profesionalentieu/lockers-unraf/HARDWARE.md

# Armado del sistema real — procedimiento de puesta a punto

Guía para pasar del simulador al gabinete funcionando. El orden importa: cada etapa se prueba
sola antes de sumar la siguiente, así cuando algo falla sabés exactamente qué lo rompió.

**La regla que más tiempo ahorra: nunca sumes dos cosas nuevas a la vez.** Si conectás el
registro de desplazamiento y los solenoides en el mismo paso y no anda, tenés dos sospechosos y
ninguna forma barata de distinguirlos.

---

## 0. Antes del viernes (hacelo ahora, son descargas)

Si esto queda para el día que llegan las placas, se les va la mañana bajando paquetes.

El firmware es **ESP-IDF 6.1** y se trabaja desde **VS Code** (ya no se usa el IDE de Arduino).
El detalle está en [`firmware/README.md`](firmware/README.md); en corto:

1. **VS Code** y la extensión **ESP-IDF** de Espressif.
2. `F1` → **ESP-IDF: Open ESP-IDF Installation Manager** → instalar **ESP-IDF v6.1** con los
   targets **esp32s3** y **esp32c3**. Son ~2 GB: no lo dejes para el día del armado.
3. Abrir `firmware/lockers.code-workspace` y compilar una vez cualquier proyecto (por ejemplo
   `pruebas/obtener_mac`): la primera compilación baja cJSON del registro de Espressif y deja
   todo listo. Las librerías ya no se instalan a mano: cada proyecto declara las suyas.

### Checklist de componentes

Además de las placas, para el prototipo hacen falta:

| Qué | Cuánto | Para qué |
|---|---|---|
| Resistencias 10 kΩ | 8 | Pull-down en los gates de los MOSFET |
| Resistencias 220–330 Ω | 4 | Para los LEDs de prueba (etapa 3) |
| SN74HC595 | 1 | Expande 3 pines del micro a 8 salidas |
| LEDs comunes | 4 | Probar el registro sin riesgo antes de conectar potencia |
| Diodos 1N4007 | 4 (uno por solenoide) | **Flyback**: sin esto se queman los MOSFET |
| Capacitor electrolítico 470–1000 µF / 25 V | 1 | Absorbe el pico de corriente del pulso |
| Capacitor cerámico 100 nF | 1 por integrado | Desacople de alimentación |
| Fuente 12 V, 2 A mínimo | 1 | El pulso de servicio dura 15 s y el firmware permite 2 bobinas a la vez: con solenoides de 600 mA son 1,2 A sostenidos; 2 A da margen para el pico de arranque |
| Multímetro | 1 | Medir consumo real y verificar continuidad |
| Protoboard y jumpers | — | Todo el armado previo al gabinete |

---

## 1. Las placas solas (30 min)

Antes de cablear nada: conectá cada placa por USB y grabá **`firmware/pruebas/obtener_mac`**
(*Build, Flash and Monitor*). Confirma cuatro cosas de una: que el cable es de datos y no solo de
carga, que el puerto aparece, que la placa entra en modo programación, y la MAC para etiquetarla.

> Si la PC no detecta la placa: mantené apretado el botón **BOOT**, conectá el USB, soltá. Eso
> fuerza el modo bootloader. En Windows revisá el Administrador de dispositivos para ver en qué
> COM aparece.

---

## 2. El enlace ESP-NOW, con nada más conectado (1 h, es la etapa crítica)

**No sigas a la etapa 3 hasta que dos placas peladas se hablen.** Sumarle registros y solenoides
a un enlace que no funciona solo agrega variables.

ESP-NOW usa el WiFi que el ESP32-S3 trae adentro, así que **no hace falta ningún módulo de radio
externo**: alcanza con las dos XIAO y sus antenas de 2,4 GHz. Verificá que la antena chica esté
conectada al conector IPEX antes de energizar.

En `firmware/pruebas/` hay dos proyectos para esta etapa (en las pruebas hay que elegir el
target: *ESP-IDF: Set Espressif Device Target* → `esp32s3`):

- **`obtener_mac`** — imprime la MAC de cada placa. El firmware usa difusión y no la necesita,
  pero anotarlas sirve para etiquetar las placas y para diagnosticar.
- **`prueba_espnow`** — ping-pong entre las dos, con RTT, RSSI de los dos extremos y porcentaje
  de entrega. Cambiás `#define ES_SONDA` (1 o 0) en `main/main.c` antes de grabar cada una.

### El canal es la falla número uno

Las dos placas tienen que estar en el **mismo canal WiFi** (`#define CANAL 1`). Si difieren, las
dos arrancan sin dar ningún error y simplemente no se ven. Antes de sospechar del código, revisá
el canal.

### La medición que importa

En la mesa el enlace va a funcionar sí o sí. Lo que hay que medir es el **alcance real en el
edificio**, porque a 2,4 GHz el hormigón atenúa mucho: una placa fija donde va a estar el gateway,
la otra caminando, anotando RSSI y porcentaje de entrega a cada distancia. Contra los cientos de
metros de LoRa, esperá entre 20 y 50 metros en un pasillo.

Esa tabla decide dónde puede estar el gateway, y queda muy bien en el informe.

---

## 3. El registro de desplazamiento, con LEDs (1 h)

Ahora sí, el SN74HC595 — pero manejando LEDs, no solenoides. Es la prueba más barata de que toda
la cadena software → radio → firmware → registro funciona.

### Conexionado

| Pin del 595 | Va a |
|---|---|
| 14 (SER / DS) | D1 = GPIO2 de la XIAO (`PIN_SR_DATOS`) |
| 11 (SRCLK) | D2 = GPIO3 (`PIN_SR_RELOJ`) |
| 12 (RCLK / LATCH) | D3 = GPIO4 (`PIN_SR_LATCH`) |
| 10 (SRCLR) | VCC (activo en bajo: si queda suelto, borra el registro) |
| 13 (OE) | GND (ver la nota de abajo) |
| 16 (VCC) y 8 (GND) | Alimentación, con un 100 nF entre ellos |
| Q0–Q3 | LED + resistencia de 330 Ω a GND |

### ⚠ Alimentación del 595: 3,3 V, no 5 V

El ESP32 trabaja a 3,3 V. Si alimentás el 595 a 5 V, su umbral de entrada alta es 0,7 × VCC =
**3,5 V**, o sea que los 3,3 V del ESP32 no alcanzan a garantizar un "1" lógico: puede andar en
el banco de pruebas y fallar de forma intermitente después. Dos salidas correctas:

- **Alimentar el 595 a 3,3 V** (lo más simple). El umbral baja a 2,31 V y el ESP32 lo maneja sin
  problema. La contra: el gate del MOSFET recibe solo 3,3 V.
- **Usar un SN74HCT595 alimentado a 5 V.** La variante **HCT** tiene entradas con niveles TTL
  (umbral 2 V), así que acepta los 3,3 V del ESP32 y entrega 5 V al gate, que es mejor para el
  MOSFET. Si todavía están a tiempo de pedir, esta es la opción más prolija.

El IRLZ44N es de nivel lógico y conmuta con 3,3 V para corrientes de este orden, pero queda menos
holgado. Si van por 3,3 V, **medí la caída entre drain y source con el solenoide activo**: si es
de décimas de volt, está bien; si el MOSFET se calienta, no está saturando y conviene pasar a
HCT a 5 V.

### El arranque

Al energizar, las salidas del 595 quedan en estado indefinido hasta el primer latch. Con OE a
masa eso se traduce en que **un solenoide puede dispararse solo al prender el equipo**. Por eso
los pull-down de 10 kΩ en cada gate. Si quieren la solución más prolija: OE con un pull-up de
10 kΩ a VCC (salidas en alta impedancia al arrancar) y un GPIO que lo lleve a masa recién después
de que el firmware puso el registro en cero.

**Prueba:** grabá `firmware/nodo`, levantá el backend y el gateway, y validá un código en la
pantalla del locker. El LED tiene que prenderse **15 segundos** (el pulso de servicio). Si eso
pasa, el software está completo y lo que falta es solo potencia.

---

## 4. Los finales de carrera (30 min)

Un extremo del microswitch a **GND**, el otro al GPIO. En el firmware tienen el pull-up interno
habilitado (`componentes/puertas`), así que en reposo leen alto y al apretarse leen bajo. No hacen
falta resistencias externas, **salvo en D6 y D7 de la XIAO** (GPIO43/44): son el TX/RX de la
UART0 y la ROM escribe en GPIO43 al arrancar; con la puerta cerrada eso es un cortocircuito breve.
Poné 1 kΩ en serie en esos dos cables (detalle en `firmware/README.md`).

Los microswitch tienen tres patas: **COM**, **NO** (normalmente abierto) y **NC** (normalmente
cerrado). **No confíes en la posición**: en algunos modelos el terminal del medio no es COM. Mirá
lo impreso en el cuerpo del switch, o probalo.

**Se usan COM y NO**, con el switch montado de modo que la puerta cerrada apriete la palanca:

| Situación | Palanca | Contacto C-NO | Lectura | Estado |
|---|---|---|---|---|
| Puerta cerrada | apretada | cerrado | LOW | cerrada |
| Puerta abierta | libre | abierto | HIGH | abierta |

Usar NC invierte todo. Y hay una razón de seguridad para preferir NO: si se corta un cable o el
switch se afloja, el circuito queda abierto y el sistema reporta **puerta abierta**, que es el
estado seguro — salta la alerta en lugar de mostrar cerrada una puerta que no lo está.

Abrí el monitor (*ESP-IDF: Monitor Device*) y verificá que aparezca `Puerta N -> ABIERTA` /
`cerrada` al soltar y apretar cada uno. El antirrebote ya está en el firmware, pero un contacto
sucio puede generar lecturas erráticas: si ves rebotes, subí `ms_antirrebote` en
`componentes/puertas/include/puertas.h` (`PUERTAS_CONFIG_DEFECTO`).

---

## 5. La potencia (1–2 h, la etapa donde se queman cosas)

> **Se puede hacer sin el registro de desplazamiento y sin radio.** Un MOSFET colgado de un GPIO
> alcanza para validar toda la cadena de una puerta. Usá
> `firmware/pruebas/prueba_actuador` (en la XIAO usa D1 como gate y D4 como switch; en la C3
> SuperMini, GPIO0 y GPIO5), que busca por barrido la duración mínima
> que necesita la cerradura y, con el comando `v`, hace el **pulso de servicio de 15 s** que pide la
> especificación (la ventana para tirar de la puerta). Hacé `v` cinco veces seguidas y tocá la
> bobina: es el peor caso real de calentamiento.

Recién ahora los 12 V. Tres cosas que arruinan prototipos, en orden de frecuencia:

**Diodo flyback.** Un solenoide es una bobina: al cortar la corriente genera un pico de tensión
inverso que puede superar los 100 V y se lleva puesto el MOSFET. El 1N4007 va en paralelo con la
bobina, **cátodo (la franja) al positivo de 12 V**. Sin este diodo el MOSFET dura horas, no meses.

**Masa común.** El negativo de la fuente de 12 V y el GND del ESP32 tienen que estar unidos. Sin
esa referencia, el gate del MOSFET no tiene contra qué medir su tensión y el circuito hace cosas
impredecibles. Es el error más común y el más difícil de diagnosticar, porque a veces "casi"
funciona.

**No alimentes el XIAO desde los 12 V** sin un regulador. Para el prototipo, dejá el XIAO por USB
y la fuente de 12 V solo para los solenoides, con las masas unidas.

### El armado por MOSFET

```
   12 V ──┬──────────────┐
          │           [solenoide]
        [1N4007]         │
   (cátodo arriba)       │
          └──────────────┤
                         │
                       DRAIN
   Q0 del 595 ──[gate]  IRLZ44N
                  │    SOURCE
               [10 kΩ]    │
                  │       │
   GND ───────────┴───────┴──── (misma masa que el ESP32)
```

### Medición antes de confiar

Con la fuente de banco (si tienen) o el multímetro en serie, **medí cuánto consume un solenoide
durante el pulso**. Los de 12 V suelen pedir entre 0,5 y 1 A, con un pico mayor al inicio. Ese
número define la fuente. Poné el capacitor de 470–1000 µF cerca de los solenoides: absorbe el
pico y evita que la tensión se hunda y reinicie el ESP32.

Con el pulso de 15 s ya no alcanza con "de a uno por vez" (dos personas en dos puertas distintas
esperarían 15 s una a la otra). El firmware permite **como máximo 2 bobinas energizadas a la vez**
(`MAX_SIMULTANEOS`) y **separa los arranques 300 ms** (`MS_ENTRE_ARRANQUES`) para que los picos no se
sumen. Si la fuente es más chica, bajen `MAX_SIMULTANEOS` a 1: la segunda orden espera su turno.

**Y la salida vuelve a cero siempre.** Si un solenoide queda energizado de más se calienta, consume
y termina quemándose. El firmware apaga cada salida al vencer su pulso (`atenderPulsos()`) y nunca
acepta más de 20 s. Si en las pruebas la bobina calienta demasiado con 15 s, la opción
`CORTAR_AL_ABRIR = true` corta apenas el switch confirma que la puerta se abrió.

---

## 6. Integración con el servidor (30 min)

### Atajo: probar el sistema completo con UNA sola placa

Si todavía no tenés la segunda XIAO para el gateway, no hace falta esperar. Grabá
**`firmware/nodo_wifi`** en una ESP32-C3 SuperMini: esa placa se conecta al WiFi y habla HTTP directo con el
backend, haciendo el trabajo del gateway y del nodo a la vez. Con eso ya tenés el circuito
completo desde el navegador — solicitud, aprobación, apertura y estado real de la puerta.

Lo único a configurar es `main/config_local.h` (copiado de `config_local.ejemplo.h`): SSID, clave,
la API key y la **IP de la PC** donde corre el backend (la que da `ipconfig`, nunca `localhost`:
desde la placa, localhost es la placa misma). Ese archivo no se sube al repositorio.

Dos condiciones: la PC y la placa en la misma red, y **el simulador apagado** — si los dos
consumen la cola de comandos, se pelean por ellos.

No es solo una muleta para la prueba: si el gabinete queda dentro del alcance del WiFi de la
facultad, esta arquitectura se puede dejar así y el proyecto se ahorra una placa entera. ESP-NOW
se justifica cuando el gabinete está fuera de cobertura o cuando no se quiere depender de la red.

### Con el gateway y el nodo separados

Con todo probado por separado:

1. Grabá `firmware/gateway` en la placa que va conectada a la PC por USB, y **cerrá el monitor**:
   el puerto lo va a usar `gateway_serie.py`.
2. Grabá `firmware/nodo` en la del gabinete.
3. Apagá el simulador y levantá el puente serie:
   ```bash
   pip install pyserial websocket-client requests
   python gateway/gateway_serie.py --puerto COM4 --backend http://localhost:3000
   ```
   (En Windows el puerto es `COM3`, `COM4`, etc. — miralo en el Administrador de dispositivos.)
4. Pedí material desde el celular, aprobalo desde Alumnado, y la puerta se abre.

El backend no nota la diferencia entre el simulador y el hardware real: hablan el mismo protocolo.
Si algo falla, volvé a prender el simulador para confirmar que el problema está del lado físico y
no del software.

---

## 7. Montaje en el gabinete

Dejalo para el final, cuando todo funcione en la mesa. Al pasar del protoboard al mueble:

- **Los cables largos de los solenoides van lejos de los del microswitch.** Un pulso de 1 A
  induce ruido en un cable de señal que corre en paralelo, y aparecen lecturas fantasma de puerta.
- Las uniones del protoboard son la causa número uno de fallas intermitentes: si el prototipo va a
  quedar instalado, soldá o usá bornera.
- La antena, lo más despejada posible: adentro de una caja de chapa el alcance se desploma.
- Etiquetá cada cable con el número de casillero. En dos semanas nadie se acuerda cuál era el bit 2.

---

## Qué hacer si algo no anda

| Síntoma | Dónde mirar primero |
|---|---|
| No compila o no graba | Ver la tabla de `firmware/README.md` (config_local.h, target, cJSON, puerto) |
| Las placas no se escuchan | **Canal distinto** entre las dos (`CANAL` en cada `main.c`), o antena floja |
| El LED del 595 no prende | SRCLR debe estar en alto y OE en bajo; verificá el cableado de SER/SRCLK/RCLK (D1/D2/D3) |
| Prenden LEDs equivocados | Orden de bits: `escribir()` en `componentes/puertas/puertas.c` manda primero el bit 7 (Q7) |
| Un microswitch de la XIAO lee mal o la placa se resetea al arrancar con la puerta cerrada | D6/D7 (GPIO43/44): falta la resistencia de 1 kΩ en serie |
| El solenoide no mueve | Tensión gate-source con el multímetro durante el pulso: si es baja, el 595 no está entregando nivel suficiente (ver etapa 3) |
| El ESP32 se reinicia al accionar | La fuente se hunde: falta el capacitor, o la fuente es chica |
| El MOSFET se calienta | No satura: pasar a HCT a 5 V, o revisar que sea IRLZ (versión lógica) y no IRF |
| Lecturas de puerta erráticas | Cable del microswitch corriendo junto al de potencia; subir el antirrebote |
| Anda en la mesa y falla en el gabinete | Uniones del protoboard, o antena tapada por la chapa |

---

## Orden sugerido para el viernes

| Momento | Qué |
|---|---|
| Antes | Instalar VS Code, la extensión y ESP-IDF 6.1 con EIM (etapa 0) |
| Primera hora | `obtener_mac` en las dos placas (etapa 1) |
| Resto de la mañana | **Enlace ESP-NOW y medición de alcance** (etapa 2) |
| Tarde | Registro con LEDs (etapa 3) y microswitches (etapa 4) |
| Otro día | Potencia (etapa 5) e integración (etapa 6) |

Si terminan con dos placas hablándose por ESP-NOW y un LED que prende cuando alguien pide material
desde el celular, el proyecto está prácticamente hecho: lo que queda es un MOSFET y un diodo por
puerta.
