profesionalentieu/lockers-unraf/(commit log)

2026-10-16 feat(firmware): soporte completo para 4 lockers por WiFi con ESP32-C3 SuperMini
2026-10-16 Actualización de lockers-unraf
2026-10-16 Implementar la especificación técnica v3 de Lockers UNRaf
    Reservas por franja (1-4 h) con stock bloqueado por unidades y horario,
    reglas por rol, código de operación y pantalla de la puerta (QR) con
    pulso de 15 s, reintento, reporte de faltantes y alerta a los 45 s.
    Máquina de estados completa: no-show, mora con sanción, devolución
    híbrida con auditoría y mitigación del turno siguiente. Esquema v4,
    PIN con bcrypt, simuladores y firmware con pulso no bloqueante,
    22 tests de escenarios y documentación actualizada.
    Claude-Session: https://claude.ai/code/session_01Tr3tamrkSPGVNHT26SCn4S
2026-10-22 Migrar el firmware de Arduino a ESP-IDF 6.1 con VS Code
    Los seis sketches pasan a proyectos ESP-IDF nativos, con la estructura
    que adoptó la cátedra en aura-firmware (ADR-007): componentes
    compartidos, sdkconfig.defaults por placa, cJSON del registro de
    Espressif y credenciales en config_local.h fuera del repo.
    - componentes/puertas: pulso de 15 s sin bloquear, máx. 2 bobinas,
    antirrebote; salida por GPIO (C3) o 74HC595 (XIAO S3).
    - componentes/enlace_espnow: difusión con cola de recepción y RSSI.
    - nodo_wifi: tareas separadas para potencia, comandos y telemetría.
    - nodo, gateway y las tres pruebas de banco.
    - lockers.code-workspace multi-proyecto y firmware/README.md.
    El protocolo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
2026-10-22 Conectar el gabinete a la mesh de AURA como nodo hoja
    - firmware/hoja_mesh: hoja ESP-IDF 6.1 sobre nodo_mesh de la cátedra y el
    componente puertas. Comando abrir {puerta, ms}, values puerta_N y
    solenoide_N en cada cambio y cada intervalo_s, set_config (intervalo_s,
    max_abierta_s) todo o nada en NVS, alertas puerta (apertura_sin_orden,
    abierta_demasiado, cerrada). C3 SuperMini (GPIO) o XIAO S3 (74HC595)
    según el target. Compila sin warnings en los dos y dentro de
    aura-firmware/dispositivos.
    - firmware/aura-firmware: submódulo de la cátedra fijado en 5d89705
    (contrato MQTT v4.1).
    - gateway/puente_mesh.py: puente MQTT <-> API de gateway del backend
    (reemplaza a gateway_serie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
2026-10-30 hoja_mesh: al día con aura-firmware (actualización por la malla)
    - Submódulo aura-firmware en a5f3746 (PR #23 y #24: aula sin red
    arriba, OTA y tipo de firmware).
    - Tipo aura-lockers y PROJECT_VER 1.0.0 (guía 2.7).
    - partitions.csv con ota_0, ota_1, otadata y cola; vuelta atrás
    automática (BOOTLOADER_APP_ROLLBACK_ENABLE).
    - Compila sin warnings para esp32c3: 1067 KB, 40 % libre de 1,75 MB.
    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
2026-11-05 Versión de un solo locker para la muestra (rama un-locker)
    - seed: solo A-01 (bit 0 del NODO-A); SEED_CUATRO_LOCKERS=1 carga los 4.
    Los 22 tests siguen pasando con los 4.
    - nodo_wifi y hoja_mesh: una puerta, gate GPIO0 y microswitch GPIO5
    (otro canal: dos pines al principio de main.c). Compilan sin warnings
    para esp32c3.
    - Simuladores con un locker; README con la versión y la sección
    "Que la placa funcione sin la laptop".
    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
2026-11-06 hoja_mesh 1.0.1: al día con aura-firmware #36 (imágenes firmadas)
    - Submódulo aura-firmware en 421925f (seguridad etapa 1: OTA firmada,
    solo se aceptan tramas de la raíz o del concentrador).
    - sdkconfig.defaults: verificación de firma RSA en las OTA, sin quemar
    eFuses (la compilación no firma; para conectarse no hace falta).
    - PROJECT_VER 1.0.1. Compila sin warnings para esp32c3.
    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
2026-11-06 hoja_mesh: script para compilar, firmar y grabar (guía 2.9)
    Con la verificación de firma activada, una imagen sin firmar aborta al
    arrancar (check_signature_on_update_check): hay que grabarla firmada.
    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
2026-11-06 grabar_firmado.ps1: no firmar dos veces y frenar si el puerto está ocupado
    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
2026-11-06 grabar_firmado.ps1: grabar el .bin firmado con esptool (idf.py flash recompilaba sin firma)
    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
2026-11-06 grabar_firmado.ps1: firmar a un archivo aparte, regenerar el .bin si falta, sin tildes
    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
2026-11-06 gateway/probar_abrir.py: mandar abrir a la hoja por MQTT y ver la respuesta
    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
